YongRui0402/aiy-voice-kit-v2-case/models/aiy-voice-kit-v2-case_assembly.step

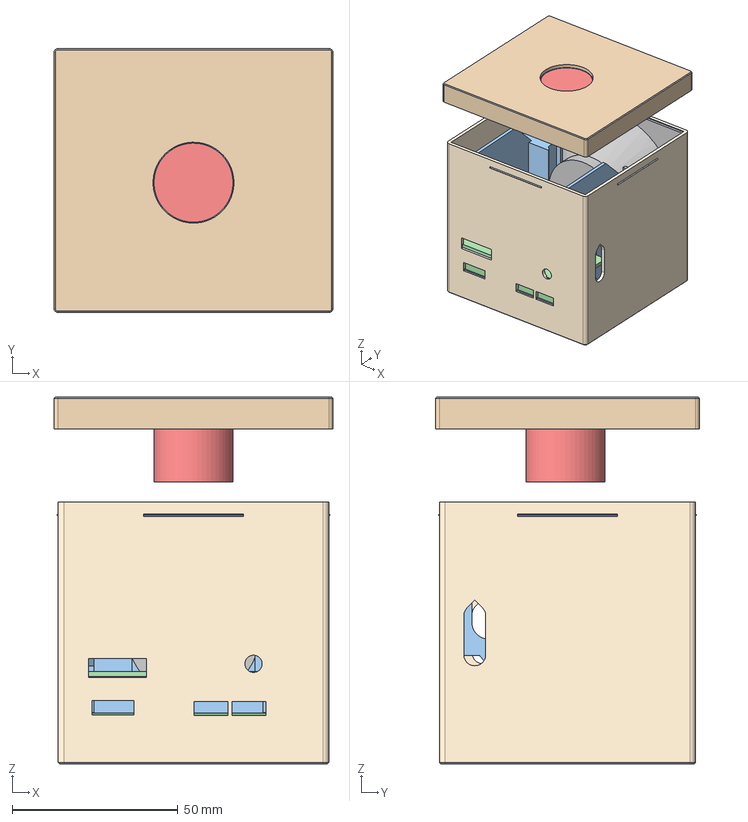
[picture p14: CAD file, 2026-11-13]
models/aiy-voice-kit-v2-case_assembly.step
84.1 x 79.6 x 110.6 mm
case_body
holder
lid_A_lifted_30mm
button_dummy_lifted_30mm
speaker_dummy
pi_zero_w_dummy
voice_bonnet_dummy
