YongRui0402/aiy-voice-kit-v2-case/models/aiy-voice-kit-v2-case_assembly_exploded.step

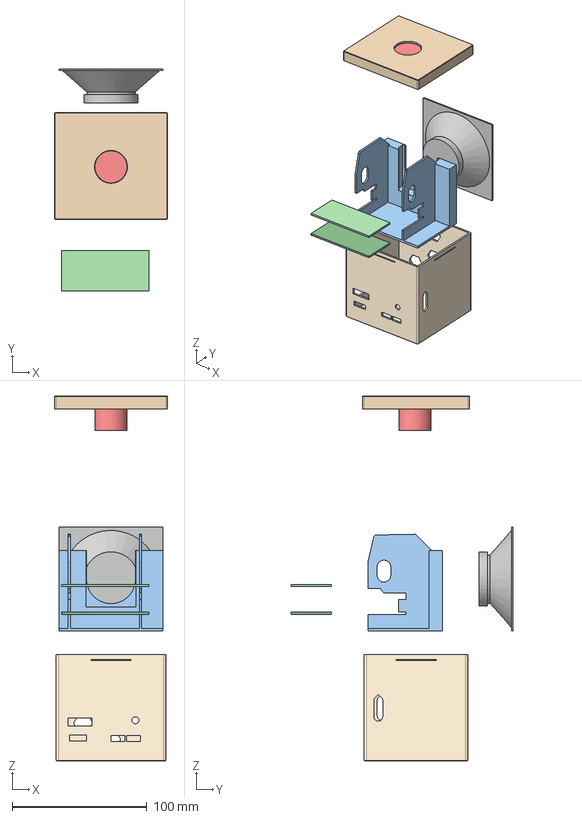
[picture p15: CAD file, 2026-11-13]
models/aiy-voice-kit-v2-case_assembly_exploded.step
84.1 x 164.5 x 270.6 mm
case_body
holder
speaker_dummy
pi_zero_w_dummy
voice_bonnet_dummy
lid_A
button_dummy
