YongRui0402/aiy-voice-kit-v2-case/models/aiy-voice-kit-v2-case_holder.step

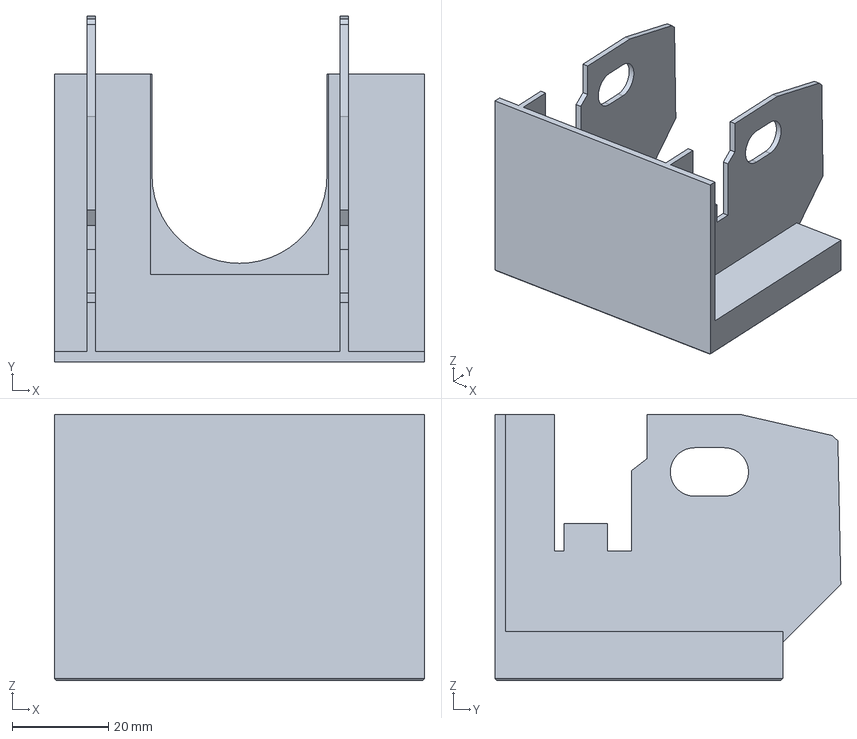
[picture p16: CAD file, 2026-11-13]
models/aiy-voice-kit-v2-case_holder.step
77.0 x 71.9 x 55.4 mm
