YongRui0402/aiy-voice-kit-v2-case/models/aiy-voice-kit-v2-case_lid.step

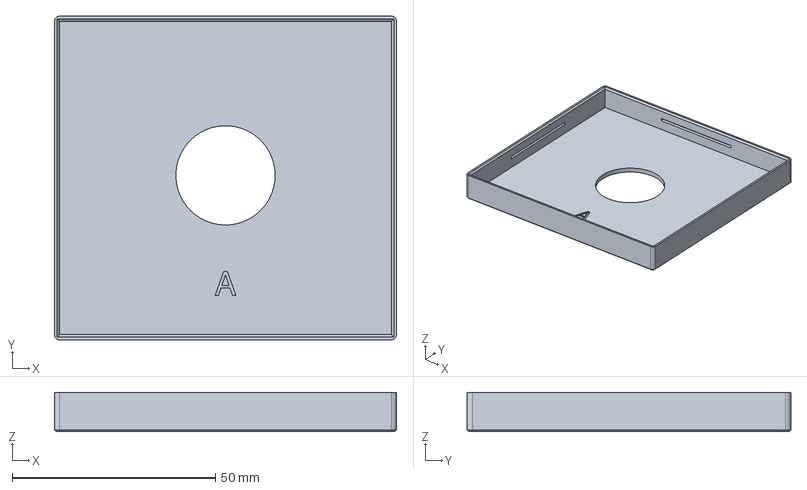
[picture p17: CAD file, 2026-11-13]
models/aiy-voice-kit-v2-case_lid.step
84.1 x 79.6 x 9.60 mm
