YongRui0402/aiy-voice-kit-v2-case/models/aiy-voice-kit-v2-case_body.step

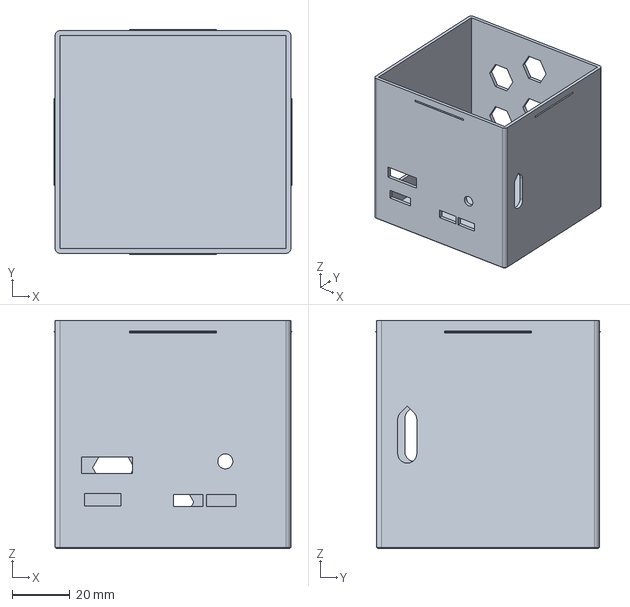
[picture p18: CAD file, 2026-11-13]
models/aiy-voice-kit-v2-case_body.step
82.4 x 77.9 x 79.0 mm
