YongRui0402/aiy-voice-kit-v2-case/(list of files, cad)

Other CAD files:
models/aiy-voice-kit-v2-case_body.stl
models/aiy-voice-kit-v2-case_holder.stl
models/aiy-voice-kit-v2-case_lid.stl
