YongRui0402/aiy-voice-kit-v2-case/(commit log)

2026-11-13 feat: initial release of AIY Voice Kit v2 case
    Body, snap-fit lid and internal holder modeled in build123d, with
    STL/STEP exports, assembly STEPs, MIT (code) and CC BY 4.0 (models).
    [aiy-voice-kit-v2-case_assembly.step, aiy-voice-kit-v2-case_assembly_exploded.step, aiy-voice-kit-v2-case_body.step, aiy-voice-kit-v2-case_body.stl, aiy-voice-kit-v2-case_holder.step, aiy-voice-kit-v2-case_holder.stl, aiy-voice-kit-v2-case_lid.step, aiy-voice-kit-v2-case_lid.stl]
2026-11-13 docs: remove claim that the original cardboard frame fits in the body
2026-11-13 docs: add MakerWorld and Printables download links
